shihab7269/Two-Switch-Multiconverter/Images/image-7.png

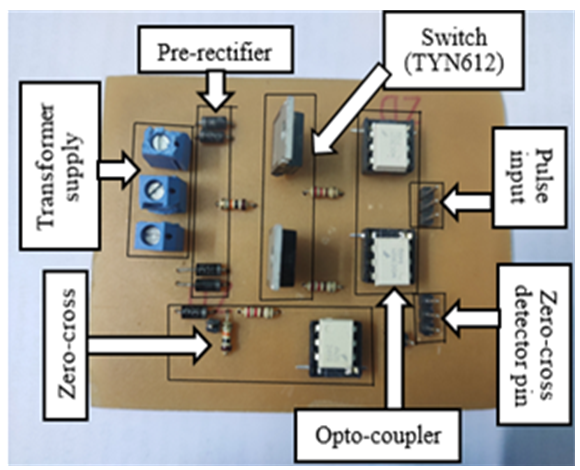
Images/image-7.png
