shihab7269/Two-Switch-Multiconverter/Images/image-8.png

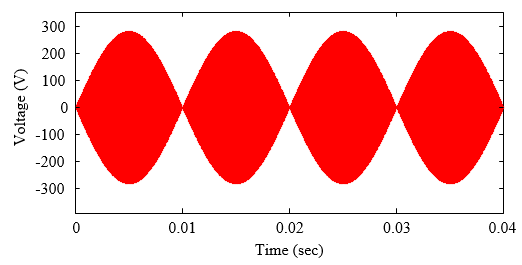
Images/image-8.png
